minsk-hackerspace/Bramnik/README.md

# Bramnik

Bramnik (gatekeeper in Belarussian) is an Open Source DIY smart lock for entrance authorization.

It synchronizes own user DB with your CMS or whatever application you use for user keeping.
