minsk-hackerspace/Bramnik/hardware/readme.md

Interface:
---------

Host Raspbbery Pi (i2c master) <->  (i2c slave) Reader Header Arduino <-> Weigant reader

Protocol:
---------

TODO:

Reader Header:
-------

https://github.com/minsk-hackerspace/Bramnik/tree/master/hardware/reader_header

TODO:
-----

add readme
