minsk-hackerspace/Bramnik/3d/README.md

# Bramnik 3d files

Cases for all hardware

Preview:
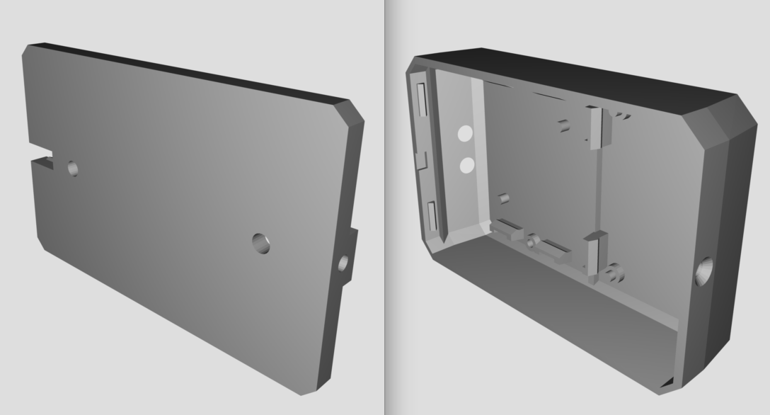
[picture p1: 3d/reader_case_preview.png]

Printed:
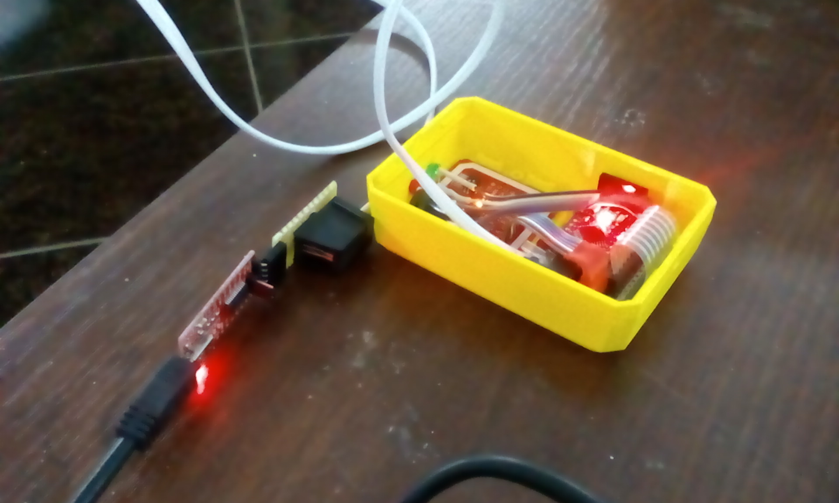
[picture p2: 3d/reader_case_printed.jpg]
