minsk-hackerspace/Bramnik/hardware/reader_header/readme.md

Reader header:
---------

Just header board for Ras perry Pi features:

- DC/DC converter supply power for Rasperry Pi
- converts i2c from 3.3v Rasperry Pi to 5v Arduino
- Arduino with onboard logic and additional Mosfet 
- Connectors for connecting any external NFC/reader/keypad (weigant)

Raspi Header Scheme:
-------

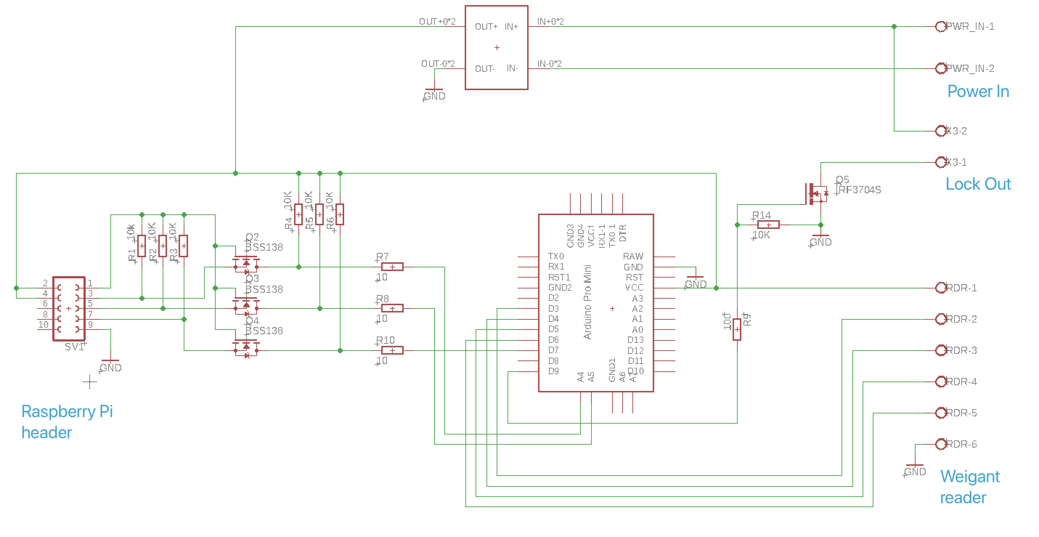
[picture p3: hardware/reader_header/h2.png]


Protocol:
---------

TODO:

TODO:
-----

add readme
