minsk-hackerspace/Bramnik/software/reader/README.md

# Bramnik Reader

Outdoor reader+keypad
Based on Adruino pro mini board
Sofrware sources
