minsk-hackerspace/Bramnik/hardware/reader_scheme.png

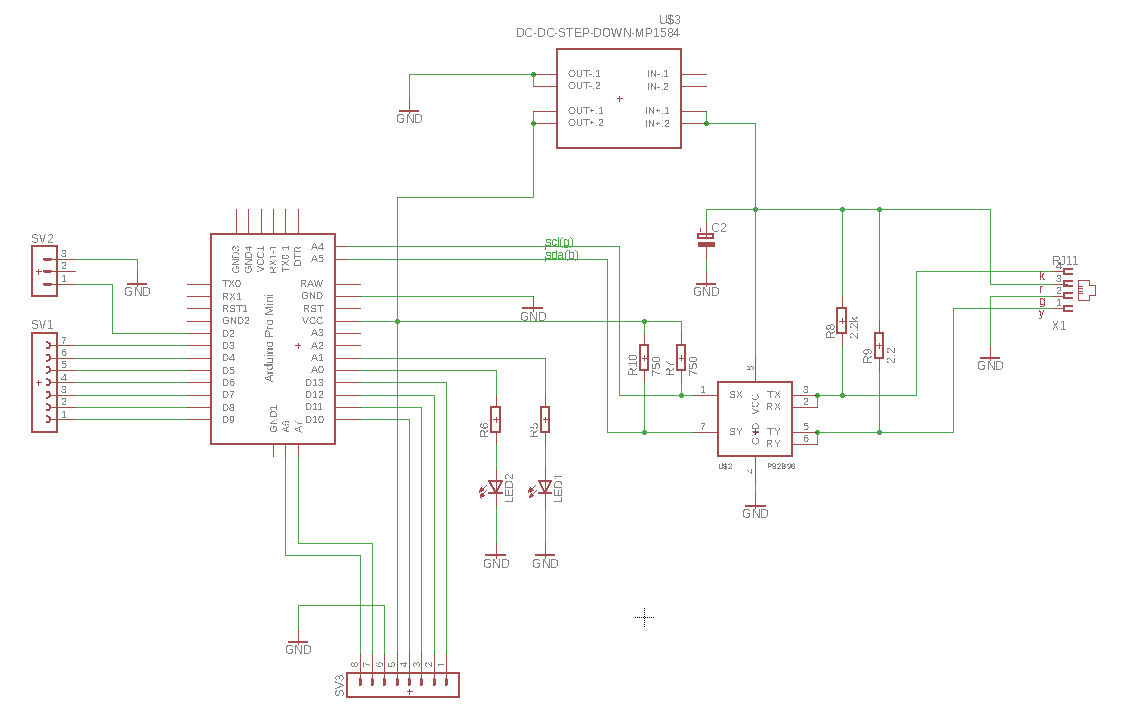
hardware/reader_scheme.png
