minsk-hackerspace/Bramnik/hardware/reader_v2/schematics.jpg

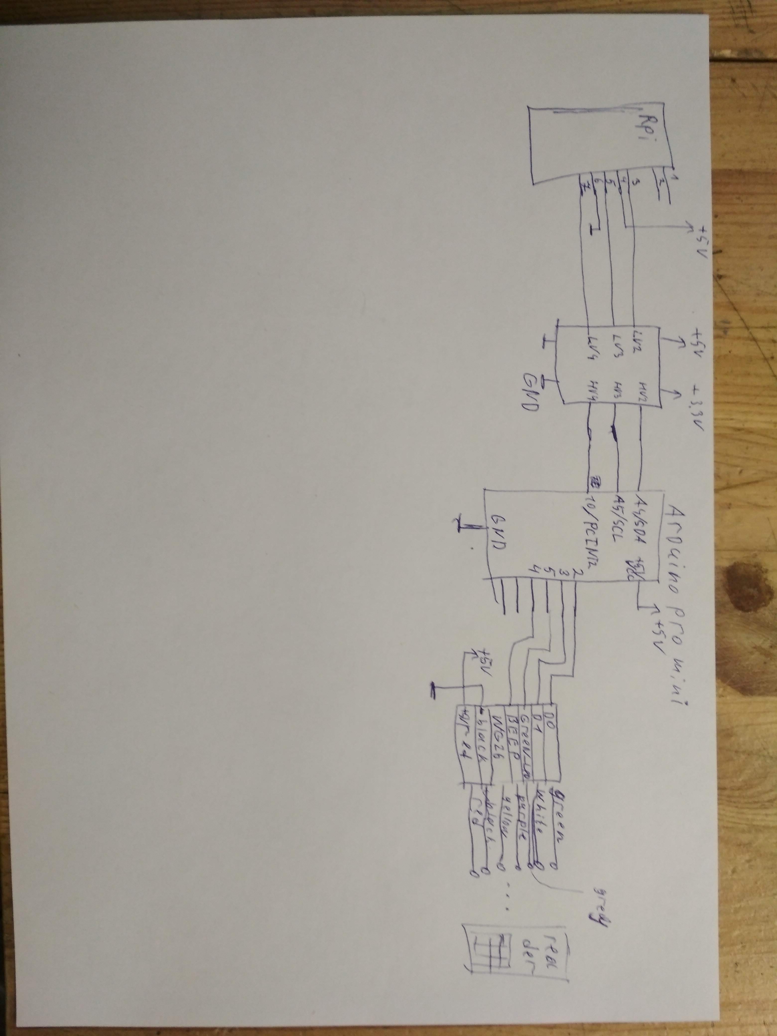
hardware/reader_v2/schematics.jpg
