minsk-hackerspace/Bramnik/3d/bram_box.dxf

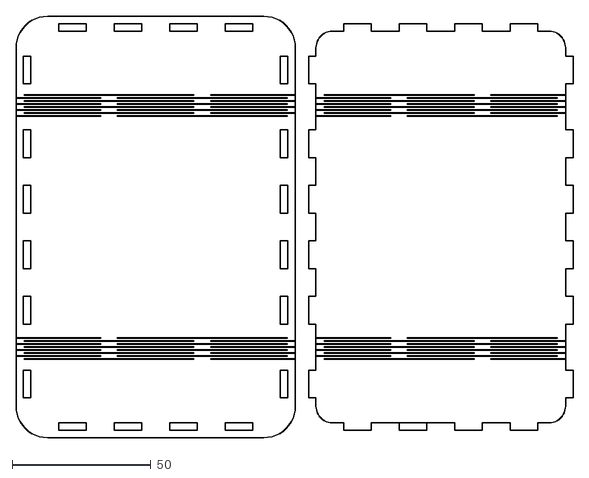
[picture p6: CAD file, 2017-04-30]
3d/bram_box.dxf
200.9 x 152.0
