minsk-hackerspace/Bramnik/hardware/Bramnik_epf/reader.dxf

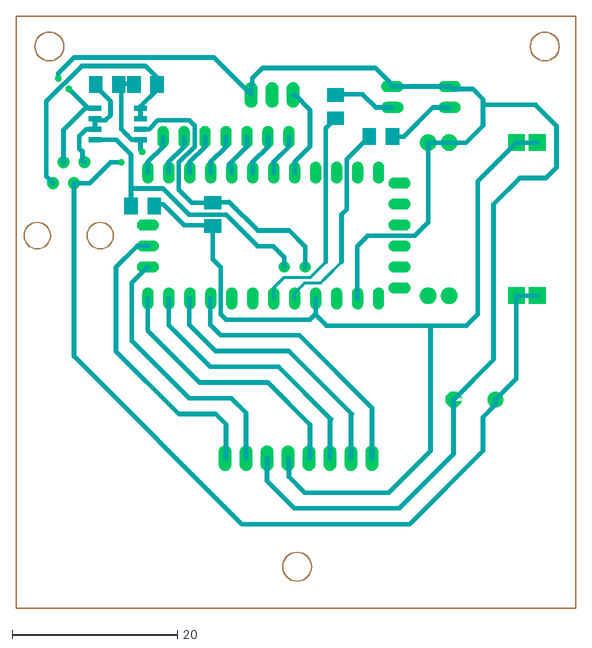
[picture p7: CAD file, 2018-09-03]
hardware/Bramnik_epf/reader.dxf
67.7 x 71.7
