minsk-hackerspace/Bramnik/3d/reader_case_p2.stl

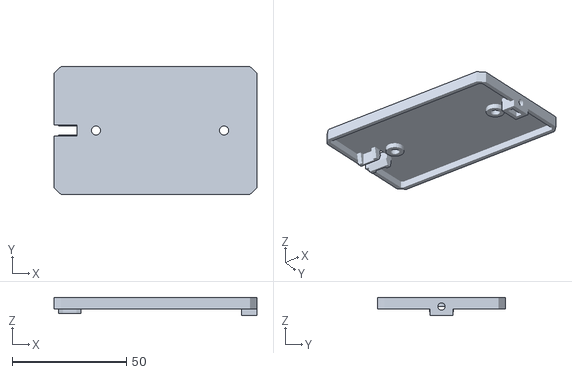
[picture p8: CAD file, 2016-06-22]
3d/reader_case_p2.stl
88.7 x 55.8 x 8.00
