minsk-hackerspace/Bramnik/3d/reader_case_p1.stl

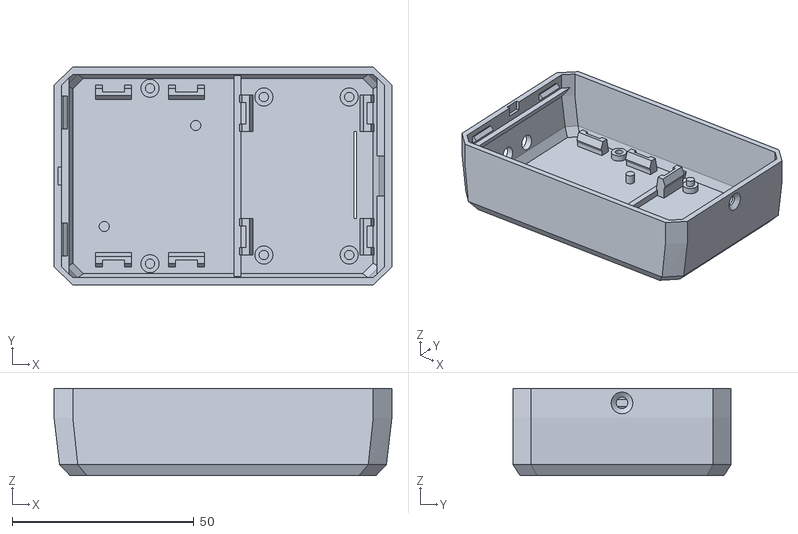
[picture p9: CAD file, 2016-06-22]
3d/reader_case_p1.stl
93.1 x 60.0 x 24.0
