minsk-hackerspace/Bramnik/(list of files, cad)

Other CAD files:
3d/reader_case.skp
