minsk-hackerspace/Bramnik/(threads)

Thread 1 (2016-07-06):

UART -> long distance i2c

Fl0p, 2016-07-06:
Пока внешний модуль работает используя 4 провода UART  (TX RX GND +5V)
- это не позволяет использовать длинную линию для его подключения
- количество внешних модулей ограничено количеством UART портов на хосте. (всего один)
  Необходимо переделать на long distance i2c через микросхему вроде p82b96
  [http://www.nxp.com/documents/data_sheet/P82B96.pdf](url)
- это сделает возможным использовать длинную линию 100 метров и больше
- вешать много ридеров c разными адресами на одну линию
- избавиться от возможного падения напряжения и питать модуль через raw 12V

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

begemotv2718, 2016-07-06:
А почему не RS485 какой-нибудь?

2016-07-06 12:08 GMT+03:00 Fl0p <notifications@github.com>:

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

jekhor, 2016-07-06:
А механизм разрешения коллизий в нём есть? Он же P2P вроде как.

begemotv2718, 2016-07-06:
Просто rs485 можно повесить поверх uart, насколько я понимаю.
А так еще CAN шину можно поставить, например.
Впрочем, наверное, long distance i2c тоже неплохо.

2016-07-06 12:19 GMT+03:00 jekhor <notifications@github.com>:

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

Fl0p, 2016-07-06:
@begemotv2718
Так RS485 это же тот-же UART только с другими уровнями.
Хочется же еще вешать много устройств на одну линию.
для этого нужна адресная шина i2c плюс поднять уровни повыше чтобы передавать подальше.

jekhor, 2016-07-06:
Не обязательно I2C, но вообще да.

Fl0p, 2016-07-20:
@begemotv2718
CAN шина это круто и вообще стандарт.
Но я глянул шилды они стоят 2-3 бакса и цепляются они по SPI
А у нас он уже занят, там висит PN532.

Я уже заказал p82b96 как придет проверю.

Fl0p, 2017-04-02:
Заработало:
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

abitrolly, 2017-06-03:
@Fl0p RS485 позволяет вешать несколько устройств на одну линию.

Closed 2017-04-02.

Thread 8 (2021-03-08):

Add IPC/network interface to get last read NFC code

jekhor, 2021-03-08:
Пользователь должен иметь возможность узнать код своей карточки. Для этого можно сделать бота или ещё какой-то интерфейс, который дожидается чтения карты и возвращает ID.

Реализовать поддержку такого сценария на стороне брамника.

abitrolly, 2021-03-08:
А просто лог публиковать не?

Thread 10 (2021-10-12):

При переносе карточки от одного юзера другому ломается синхронизация баз

jekhor, 2021-10-12:
Если на сайте ID карточки у одного пользователя удалили, а другому сразу же его добавили, то при синхронизации может возникнуть ошибка, связанная с валидацией уникальности карт:
```
root@bramnik:/srv/Bramnik/software/host# ./run_sync.sh
  % Total    % Received % Xferd  Average Speed   Time    Time     Time  Current
                                 Dload  Upload   Total   Spent    Left  Speed
100 20523    0 20523    0     0  16362      0 --:--:--  0:00:01 --:--:-- 16379
Traceback (most recent call last):
  File "/srv/Bramnik/software/host/env/lib/python3.7/site-packages/peewee.py", line 6741, in get
    return clone.execute(database)[0]
  File "/srv/Bramnik/software/host/env/lib/python3.7/site-packages/peewee.py", line 4184, in __getitem__
    return self.row_cache[item]
IndexError: list index out of range

During handling of the above exception, another exception occurred:

Traceback (most recent call last):
  File "/srv/Bramnik/software/host/env/lib/python3.7/site-packages/peewee.py", line 6360, in get_or_create
    return query.get(), False
  File "/srv/Bramnik/software/host/env/lib/python3.7/site-packages/peewee.py", line 6746, in get
    (clone.model, sql, params))
models.CardDoesNotExist: <Model: Card> instance matching query does not exist:
SQL: SELECT "t1"."id", "t1"."user_id", "t1"."card_id" FROM "cards" AS "t1" WHERE (("t1"."user_id" = ?) AND ("t1"."card_id" = ?)) LIMIT ? OFFSET ?
Params: [23, '2c4aae9c', 1, 0]

During handling of the above exception, another exception occurred:

Traceback (most recent call last):
  File "bramnik_mgr.py", line 170, in <module>
    main()
  File "bramnik_mgr.py", line 166, in main
    cli()
  File "/srv/Bramnik/software/host/env/lib/python3.7/site-packages/click/core.py", line 764, in __call__
    return self.main(*args, **kwargs)
  File "/srv/Bramnik/software/host/env/lib/python3.7/site-packages/click/core.py", line 717, in main
    rv = self.invoke(ctx)
  File "/srv/Bramnik/software/host/env/lib/python3.7/site-packages/click/core.py", line 1137, in invoke
    return _process_result(sub_ctx.command.invoke(sub_ctx))
  File "/srv/Bramnik/software/host/env/lib/python3.7/site-packages/click/core.py", line 1137, in invoke
    return _process_result(sub_ctx.command.invoke(sub_ctx))
  File "/srv/Bramnik/software/host/env/lib/python3.7/site-packages/click/core.py", line 956, in invoke
    return ctx.invoke(self.callback, **ctx.params)
  File "/srv/Bramnik/software/host/env/lib/python3.7/site-packages/click/core.py", line 555, in invoke
    return callback(*args, **kwargs)
  File "bramnik_mgr.py", line 58, in sync
    card, created = Card.get_or_create(user_id=user.id, card_id=sanitized_key)
  File "/srv/Bramnik/software/host/env/lib/python3.7/site-packages/peewee.py", line 6362, in get_or_create
    raise exc
  File "/srv/Bramnik/software/host/env/lib/python3.7/site-packages/peewee.py", line 6357, in get_or_create
    return cls.create(**kwargs), True
  File "/srv/Bramnik/software/host/env/lib/python3.7/site-packages/peewee.py", line 6235, in create
    inst.save(force_insert=True)
  File "/srv/Bramnik/software/host/env/lib/python3.7/site-packages/peewee.py", line 6433, in save
    pk = self.insert(**field_dict).execute()
  File "/srv/Bramnik/software/host/env/lib/python3.7/site-packages/peewee.py", line 1845, in inner
    return method(self, database, *args, **kwargs)
  File "/srv/Bramnik/software/host/env/lib/python3.7/site-packages/peewee.py", line 1916, in execute
    return self._execute(database)
  File "/srv/Bramnik/software/host/env/lib/python3.7/site-packages/peewee.py", line 2665, in _execute
    return super(Insert, self)._execute(database)
  File "/srv/Bramnik/software/host/env/lib/python3.7/site-packages/peewee.py", line 2400, in _execute
    cursor = database.execute(self)
  File "/srv/Bramnik/software/host/env/lib/python3.7/site-packages/peewee.py", line 3070, in execute
    return self.execute_sql(sql, params, commit=commit)
  File "/srv/Bramnik/software/host/env/lib/python3.7/site-packages/peewee.py", line 3064, in execute_sql
    self.commit()
  File "/srv/Bramnik/software/host/env/lib/python3.7/site-packages/peewee.py", line 2831, in __exit__
    reraise(new_type, new_type(exc_value, *exc_args), traceback)
  File "/srv/Bramnik/software/host/env/lib/python3.7/site-packages/peewee.py", line 183, in reraise
    raise value.with_traceback(tb)
  File "/srv/Bramnik/software/host/env/lib/python3.7/site-packages/peewee.py", line 3057, in execute_sql
    cursor.execute(sql, params or ())
peewee.IntegrityError: UNIQUE constraint failed: cards.card_id
```

abitrolly, 2021-10-13:
Надо пояснить. Одна база в RPi на брамнике, а вторая - это база с сайта https://hackerspace.by ?

Thread 9 (2021-10-12):

Не удаляются пользователи, отсутствующие в .json с сервера

jekhor, 2021-10-12:
Сабж. Из-за этого сохраняется доступ у забаненных пользователей (сейчас решено временно на стороне сервера).

jekhor, 2021-10-13:
Экспортом полного списка юзеров, а не только активных

ср, 13 кас 2021, 11:06 карыстальнік Anatoli Babenia <
***@***.***> напісаў:

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

abitrolly, 2021-10-13:
Карочи https://github.com/minsk-hackerspace/Bramnik/pull/12 удаляет все левые карточки из брамника. Этого должно хватить, чтобы не плодить лишние API.

Closed 2021-12-01.
