minsk-hackerspace/Bramnik/hardware/reader_header/h2.brd

## EAGLE design hardware/reader_header/h2.brd (2020-02-29)

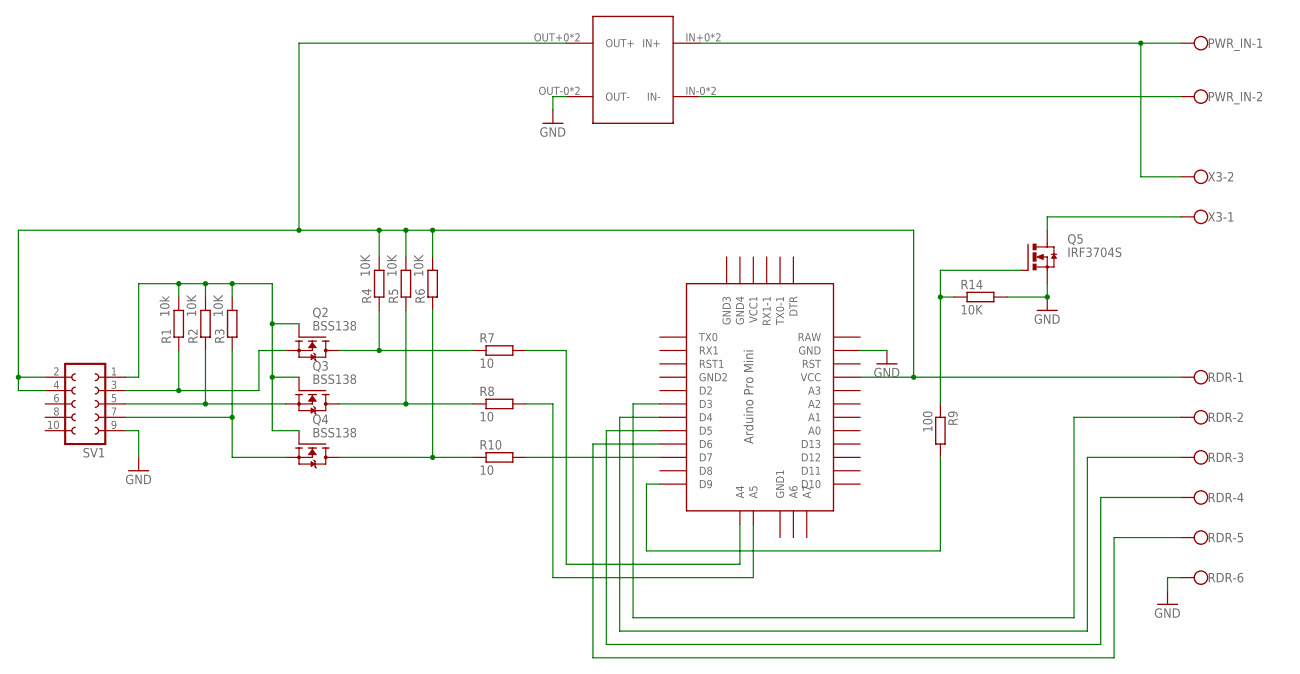
[picture p10: schematic h2.sch]

Parts:
PWR_IN: W237-102
Q2, Q3, Q4: BSS138; SOT23
Q5: IRF3704S; D2PACK
R1: 10k; R1206
R2, R3, R4, R5, R6, R14: 10K; R1206
R7, R8, R10: 10; R1206
R9: 100; R1206
RDR: W237-136
SV1: FE05-2
U$1: DC/DC4.5-20-ADJ; 23X17_8P
U$4: ABK-PRO-MINI
X3: W237-102

Connections:
GND: Q5.3 (S), R14.2, RDR.6, SV1.9, U$1.OUT-0 (OUT-), U$1.OUT-1 (OUT-), U$4.GND
unnamed: Q2.2 (S), R1.1, SV1.3
unnamed: Q2.1 (G), Q3.1 (G), Q4.1 (G), R1.2, R2.2, R3.2, SV1.1
unnamed: Q2.3 (D), R4.1, R7.1
unnamed: Q3.2 (S), R2.1, SV1.5
unnamed: Q4.2 (S), R3.1, SV1.7
unnamed: R8.2, U$4.A5
unnamed: RDR.2, U$4.D3
unnamed: R4.2, R5.2, R6.2, RDR.1, SV1.2, SV1.4, U$1.OUT+0 (OUT+), U$1.OUT+1 (OUT+), U$4.VCC
unnamed: R10.2, U$4.D7
unnamed: Q3.3 (D), R5.1, R8.1
unnamed: Q4.3 (D), R6.1, R10.1
unnamed: R7.2, U$4.A4
unnamed: PWR_IN.2, U$1.IN-0 (IN-), U$1.IN-1 (IN-)
unnamed: Q5.2 (D), X3.1
unnamed: R9.2, U$4.D9
unnamed: Q5.1 (G), R9.1, R14.1
unnamed: RDR.3, U$4.D4
unnamed: RDR.4, U$4.D5
unnamed: RDR.5, U$4.D6
PWR+12: PWR_IN.1, U$1.IN+0 (IN+), U$1.IN+1 (IN+), X3.2

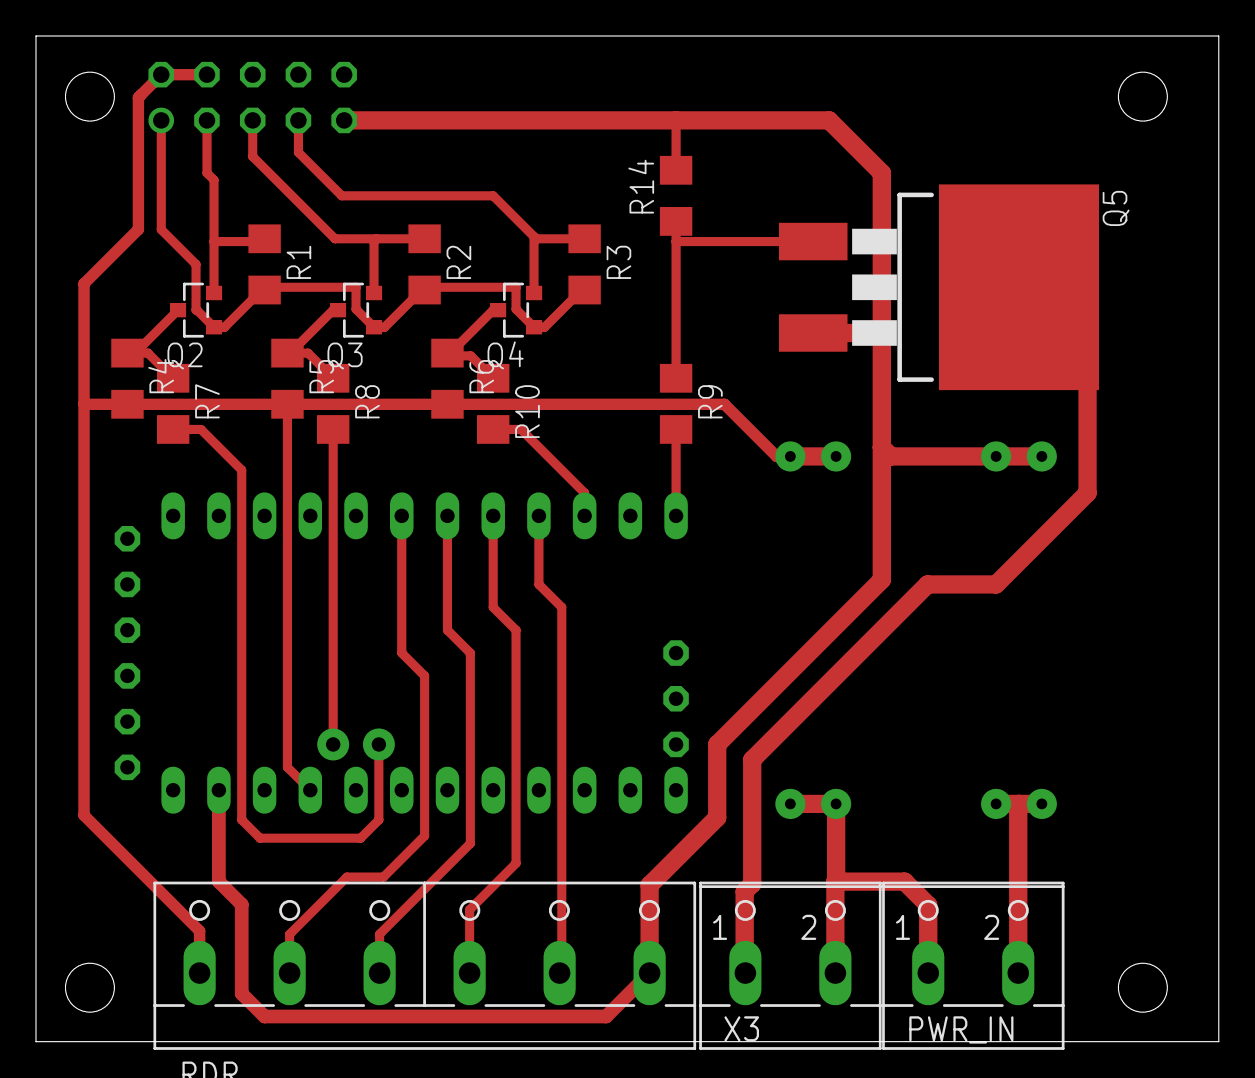
[picture p11: board h2.brd from above]

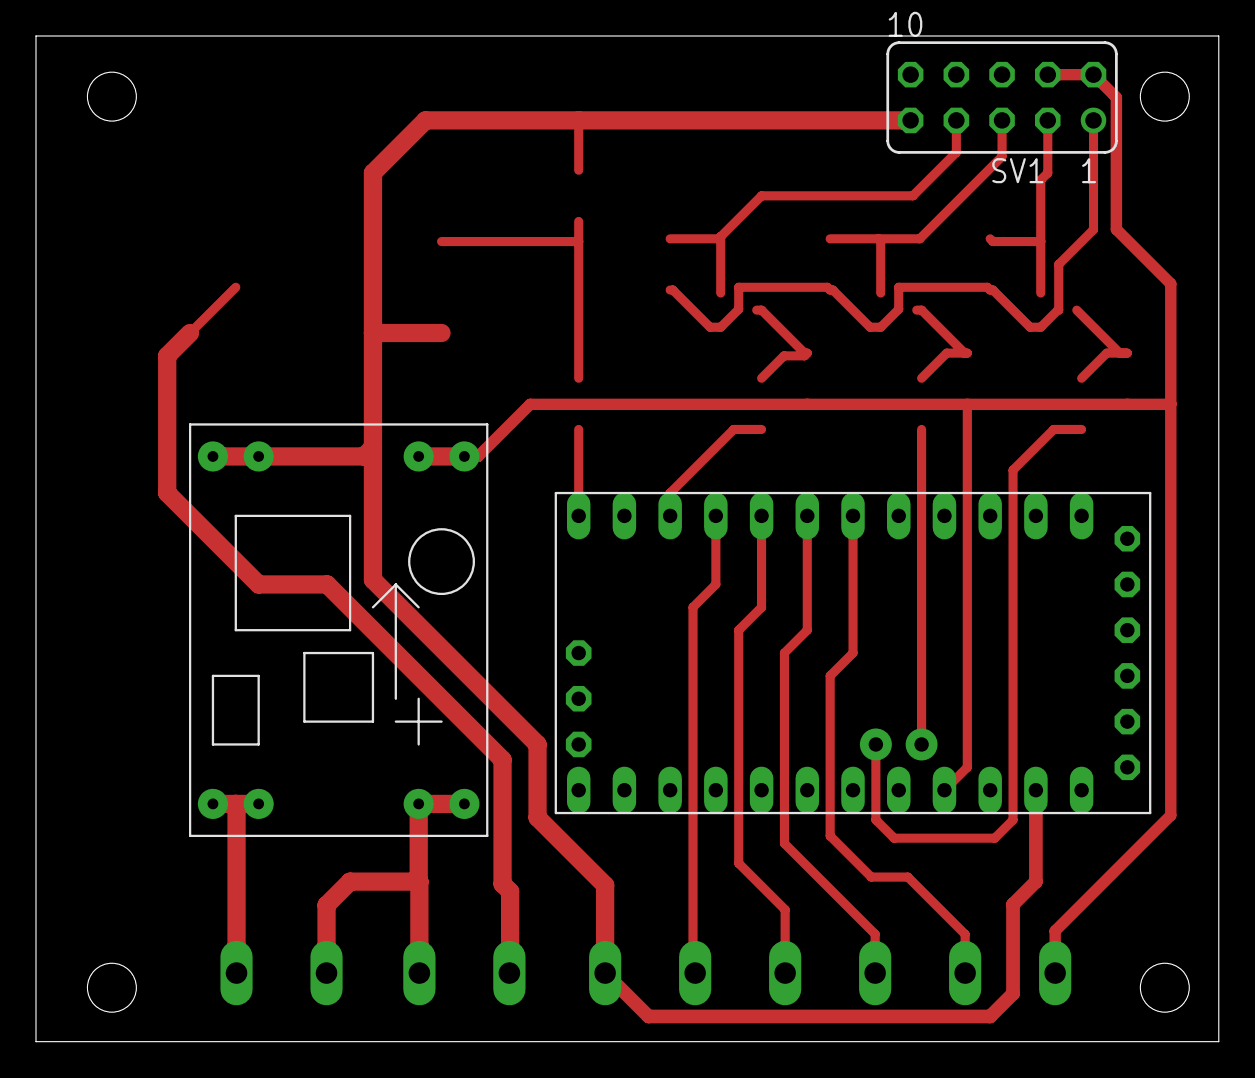
[picture p12: board h2.brd from below]

Board: 2 copper layers, 65.7 x 55.9 mm, 21 parts (3 on the bottom side), 21 nets.
