minsk-hackerspace/Bramnik/hardware/Bramnik_epf/reader.brd

## EAGLE design hardware/Bramnik_epf/reader.brd (2018-09-03)

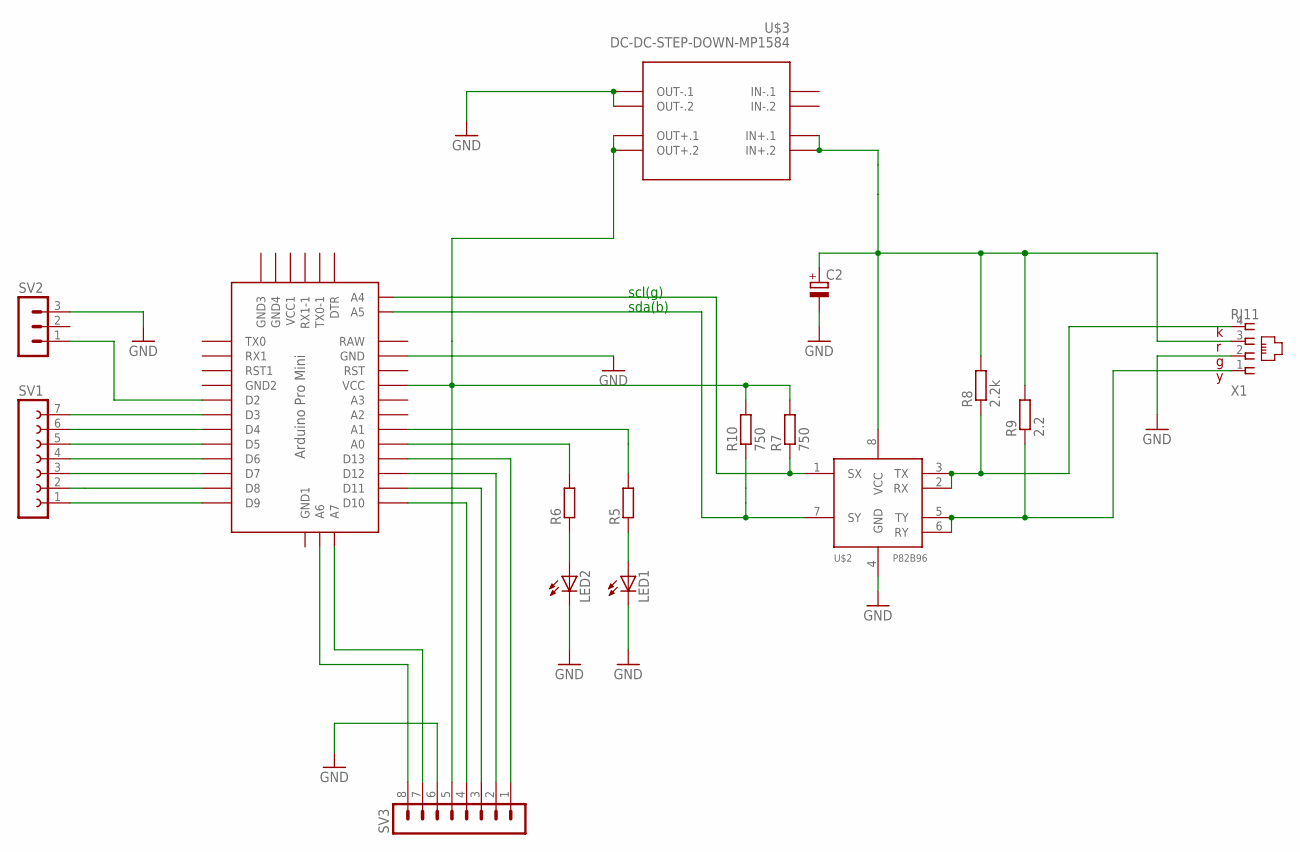
[picture p13: schematic reader.sch]

Parts:
C2: CPOL-EUE5-6; E5-6
LED1, LED2: LEDB152; Q62902-B152
R5, R6: R-EU_M1206; M1206
R7, R10: 750; M1206
R8: 2.2k; M1206
R9: 2.2; M1206
SV1: FE07-1; FE07
SV2: MA03-1
SV3: MA08-1
U$1: ABK-PRO-MINI
U$2: P82B96_; SOIC8
U$3: DC-DC-STEP-DOWN-MP1584
X1: RJ11; RJ11-4P4C

Connections:
GND: C2.-, LED1.K (C), LED2.K (C), SV2.3, SV3.6, U$1.GND, U$2.4 (GND), U$3.OUT-.1, U$3.OUT-.2, X1.2
unnamed: SV1.1, U$1.D9
unnamed: R7.1, U$1.A4, U$2.1 (SX)
unnamed: R10.1, U$1.A5, U$2.7 (SY)
unnamed: R8.1, U$2.2 (RX), U$2.3 (TX), X1.4
unnamed: SV3.1, U$1.D13
unnamed: R9.1, U$2.5 (TY), U$2.6 (RY), X1.1
unnamed: SV1.2, U$1.D8
unnamed: C2.+, R8.2, R9.2, U$2.8 (VCC), U$3.IN+.1, U$3.IN+.2, X1.3
unnamed: SV1.3, U$1.D7
unnamed: SV1.4, U$1.D6
unnamed: SV1.5, U$1.D5
unnamed: SV1.6, U$1.D4
unnamed: SV1.7, U$1.D3
unnamed: SV3.2, U$1.D12
unnamed: SV2.1, U$1.D2
unnamed: R5.2, U$1.A1
unnamed: R6.2, U$1.A0
unnamed: LED1.A, R5.1
unnamed: LED2.A, R6.1
unnamed: SV3.3, U$1.D11
unnamed: R7.2, R10.2, SV3.5, U$1.VCC, U$3.OUT+.1, U$3.OUT+.2
unnamed: SV3.4, U$1.D10
unnamed: SV3.7, U$1.A7
unnamed: SV3.8, U$1.A6

Notes on the sheet:
scl(g)
sda(b)

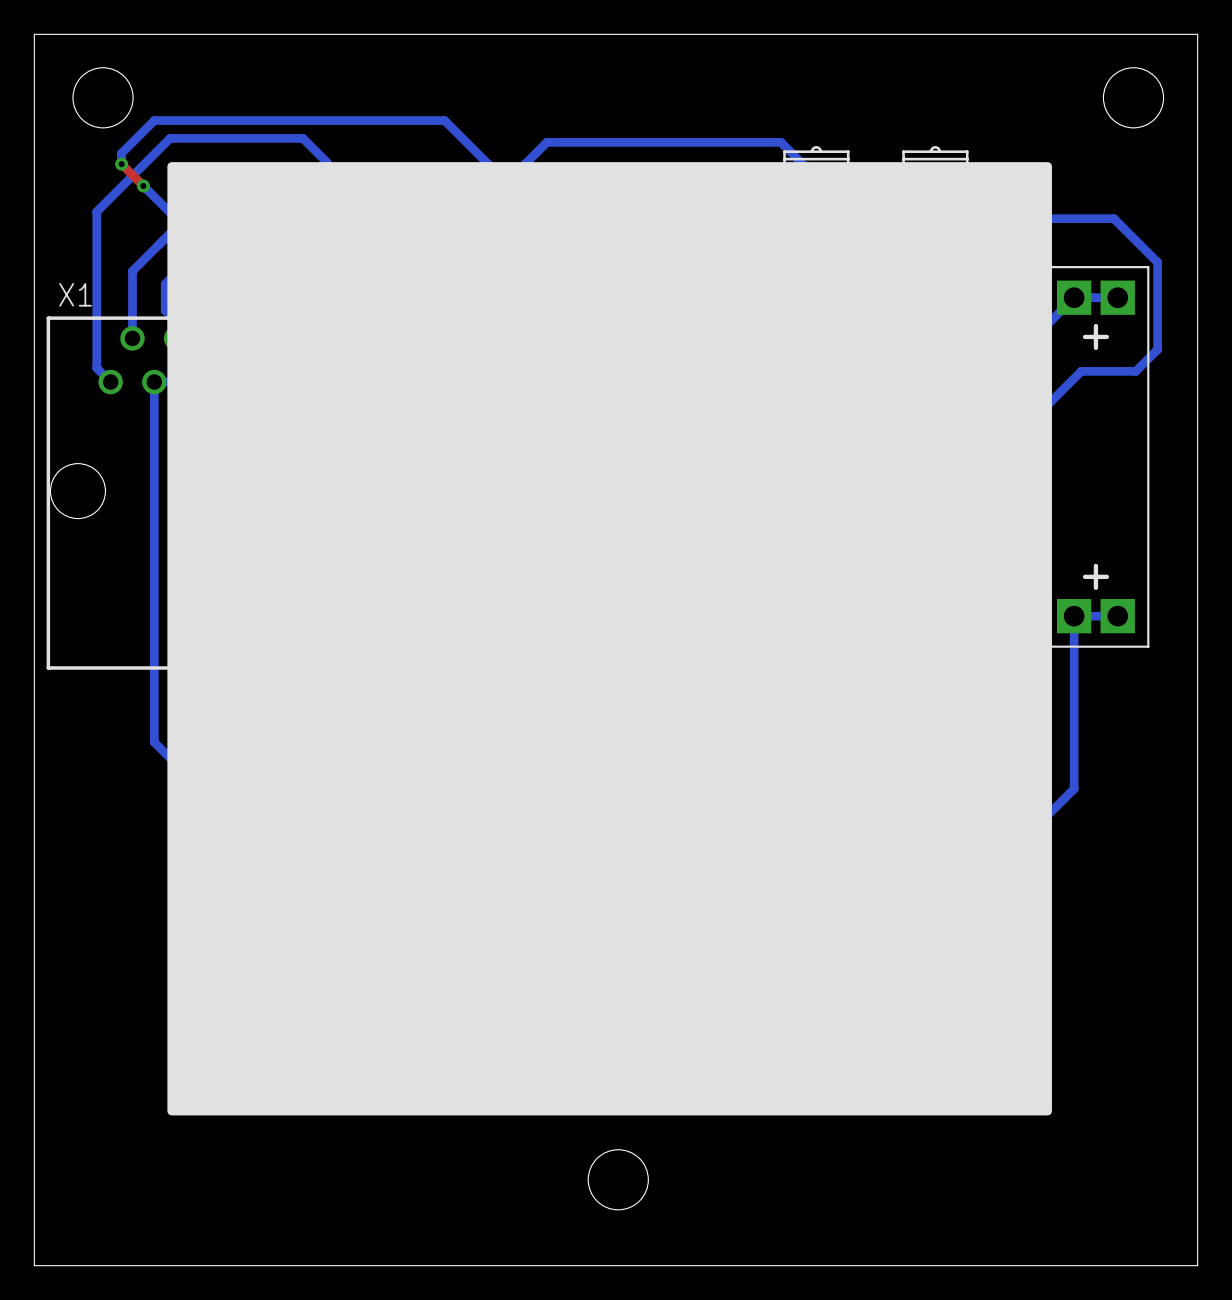
[picture p14: board reader.brd from above]

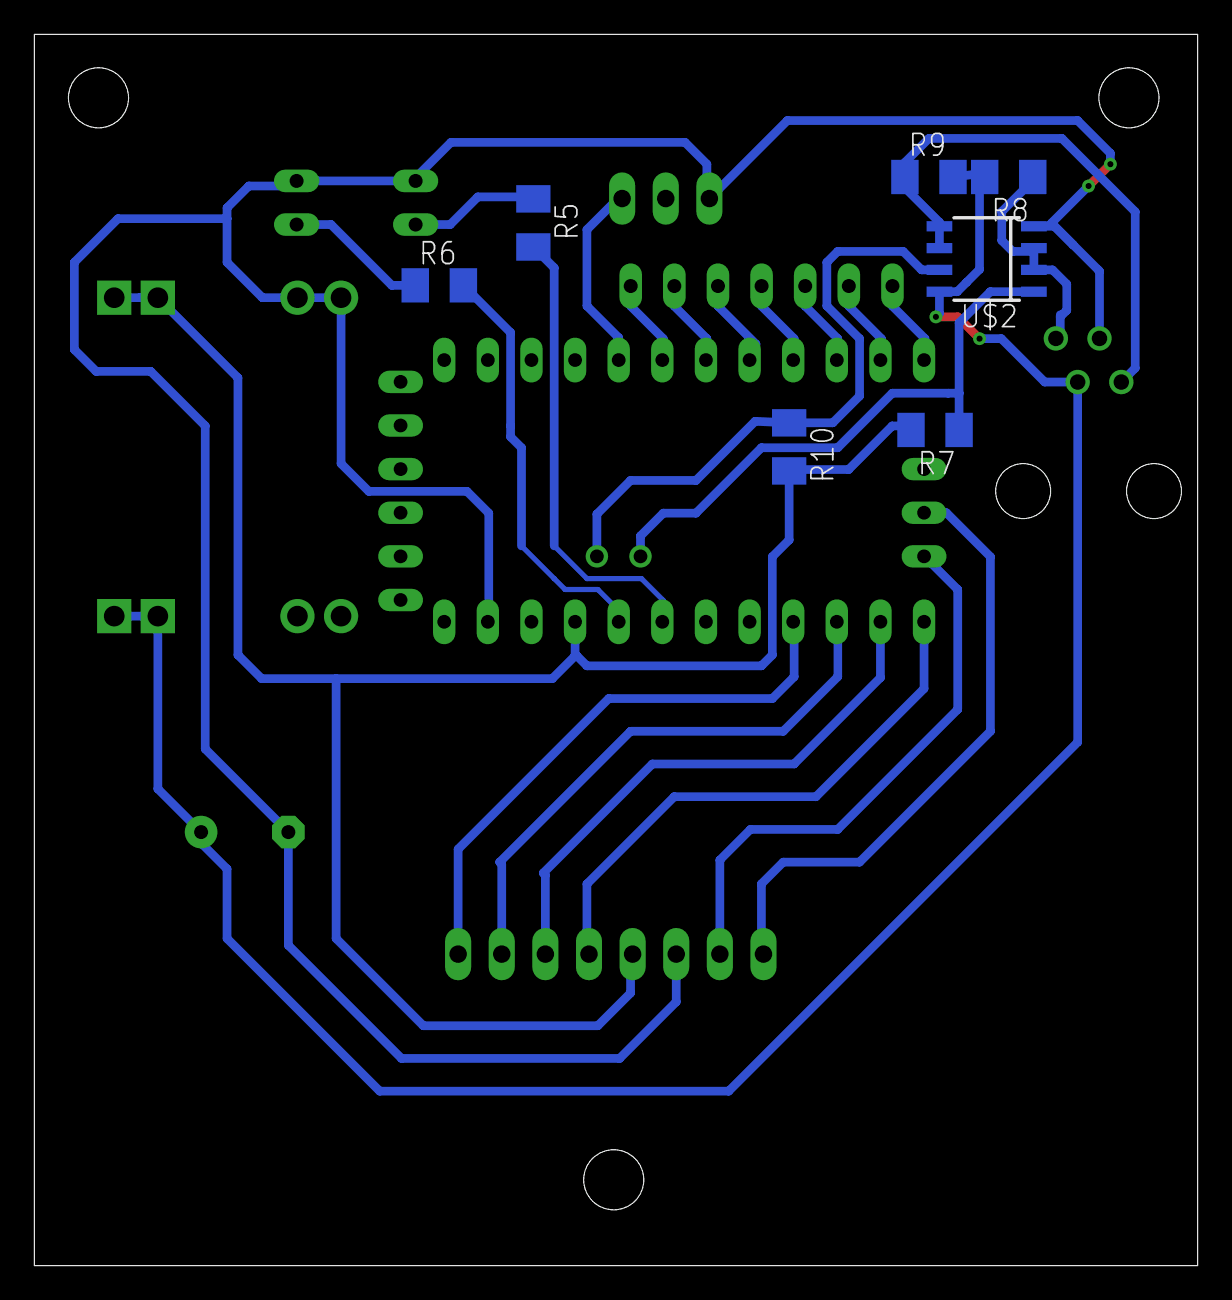
[picture p15: board reader.brd from below]

Board: 2 copper layers, 67.7 x 71.7 mm, 16 parts (7 on the bottom side), 25 nets.
