minsk-hackerspace/Bramnik/(commit log)

2016-09-07 Add reader external connector specification
2016-09-07 Add image of the printed version
2017-04-03 Add first scheme Update i2c long distance
    [reader.sch]
2017-04-03 Add test i2c scetch
2017-04-04 Update readme.md
    Add sample protocol communication between reader and host
2017-04-30 add host case
    [bram_box.dxf, bram_box.scad]
2017-05-21 - NFC report debounce. Added wire NFC reporting code as comment
2017-05-22 - Blindly merge wire code. Tests on hardware are needed.
2018-09-03 Upd scheme
    [reader.brd, reader.dxf, reader.sch]
2019-01-20 Add open door sensor
2019-12-28 Add examples for new reader HW (Wiegand reader plus arduino interface board)
2020-01-18 Add reader v2 schematics
2020-02-29 Add READER HEADER
    [h2.brd, h2.sch]
2020-03-08 Fix card byte order
    [host.py]
2020-03-08 Update sync, refactor logs, fix nfc code length
    [bramnik_mgr.py, host.py]
2020-03-08 cron sample
2021-03-07 host.py: Replace delay with thread synchronization events
    [host.py]
2021-03-07 Set right pin for "open the lock" function
2021-03-07 Add button to open the door inside of hackerspace
2021-03-11 Support for short codes (less than 8 digits)
    [bramnik_mgr.py, host.py]
2021-11-27 host.py: Use constant to define IRQ pin number
2022-02-05 host.py: Replace card.user by card.user_id
    [host.py]
2022-02-05 bramnik_mgr: Fix emit code output (show user id instead of name)
    [bramnik_mgr.py]
